servomouse/Tube_amplifier/Pics/Tube_amplifier_V0.1.jpg

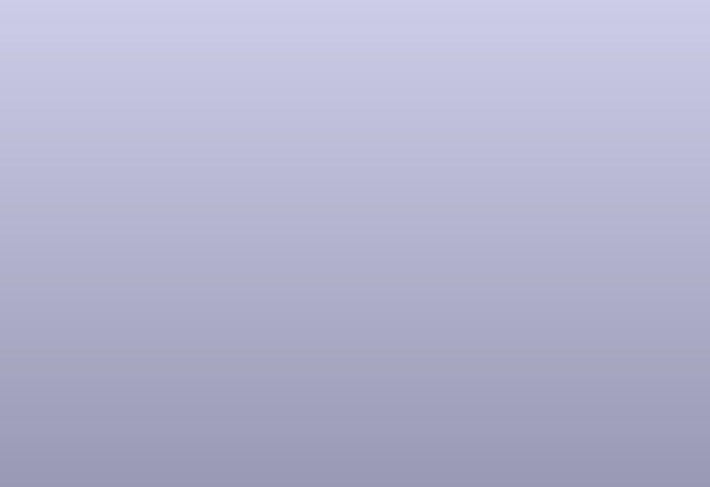
Pics/Tube_amplifier_V0.1.jpg
