servomouse/Tube_amplifier/Amplifier.png

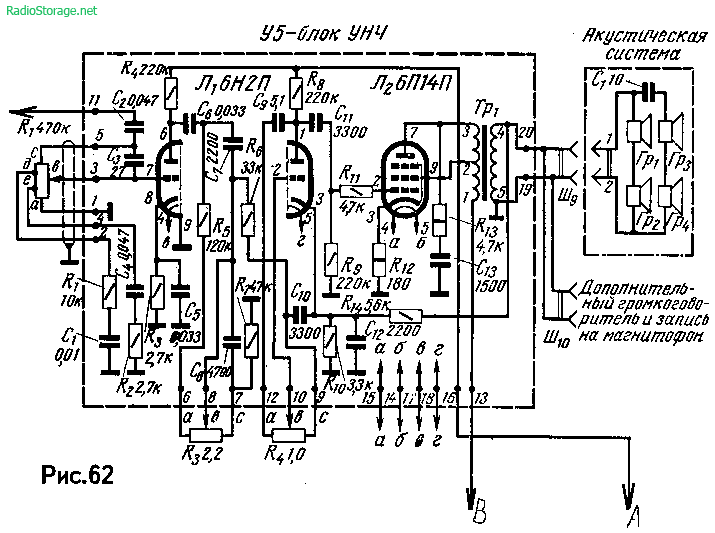
Amplifier.png
