servomouse/Tube_amplifier/Pics/lunch.jpg

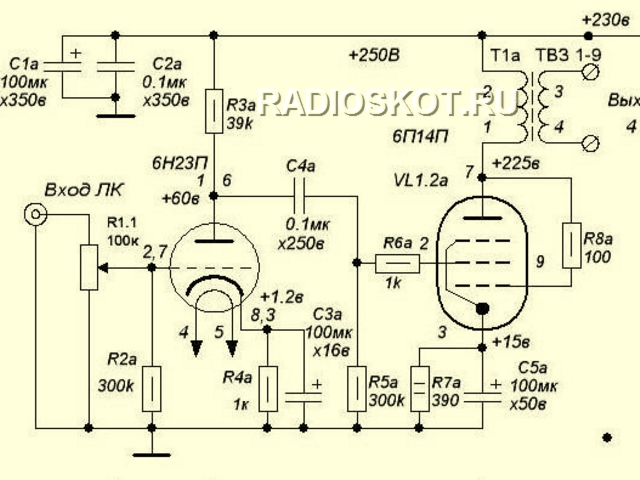
Pics/lunch.jpg
