servomouse/Tube_amplifier/Power supply.png

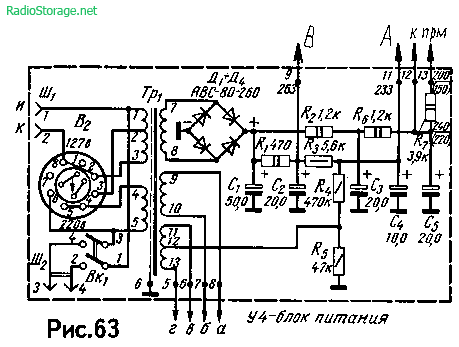
Power supply.png
