servomouse/Tube_amplifier/Transformer_params.png

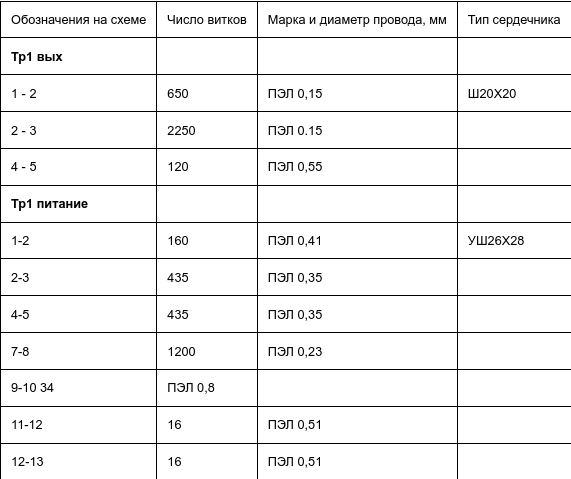
Transformer_params.png
