servomouse/Tube_amplifier/3d models/Chassis-Main_horizontal_plate.stl

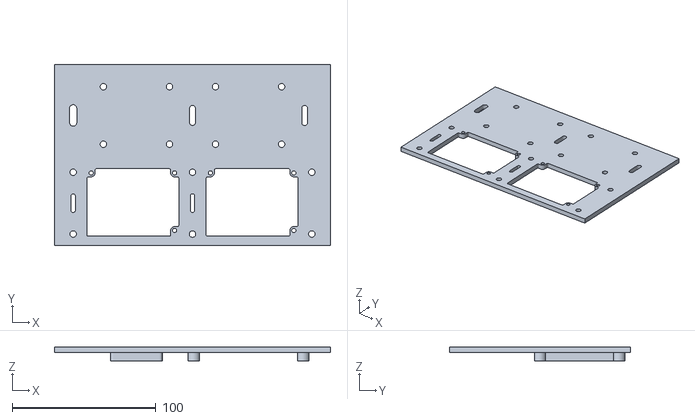
[picture p6: CAD file, 2023-05-01]
3d models/Chassis-Main_horizontal_plate.stl
192.0 x 126.0 x 10.0
