servomouse/Tube_amplifier/3d models/Transformers_holder_main.stl

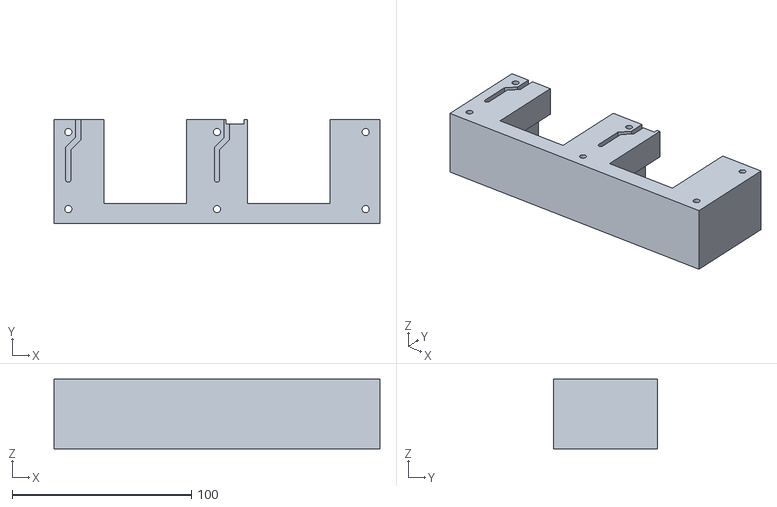
[picture p7: CAD file, 2023-05-01]
3d models/Transformers_holder_main.stl
182.0 x 58.0 x 39.0
