servomouse/Tube_amplifier/3d models/Asm.FCStd

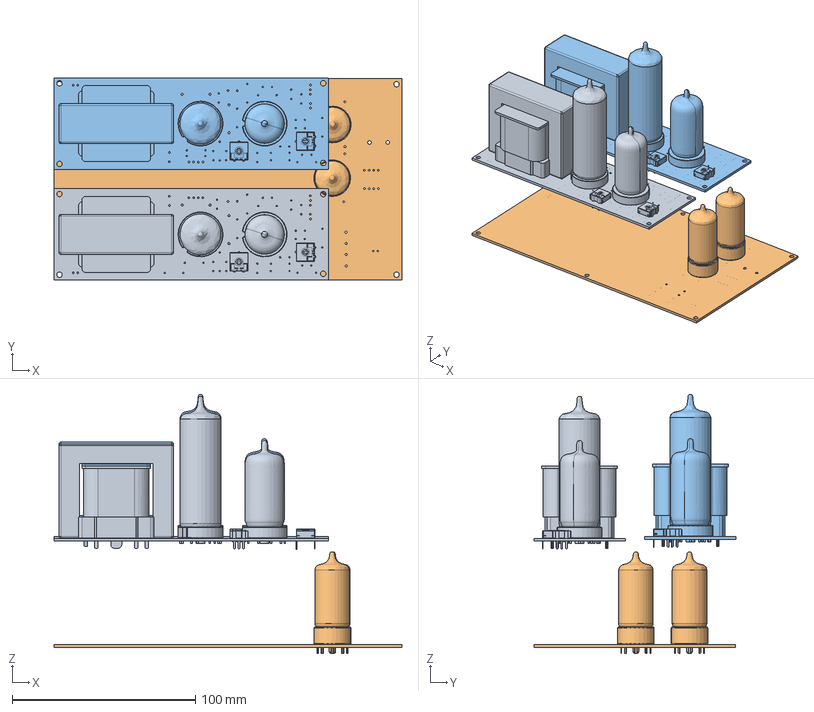
[picture p8: CAD file, 2022-12-16]
3d models/Asm.FCStd
190.0 x 110.5 x 141.5 mm
left_channel
Power_supply
right_channel
