servomouse/Tube_amplifier/3d models/Transformers_holder_inthemiddlestl.stl

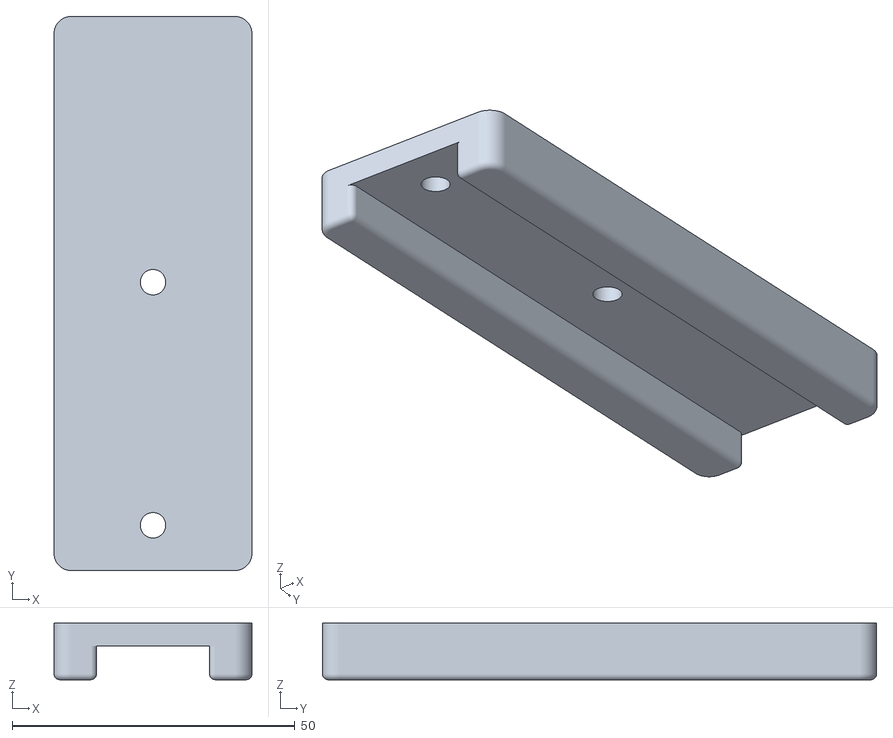
[picture p9: CAD file, 2023-05-01]
3d models/Transformers_holder_inthemiddlestl.stl
35.0 x 98.0 x 10.0
