servomouse/Tube_amplifier/3d models/Angle_mounted_SG2P.step

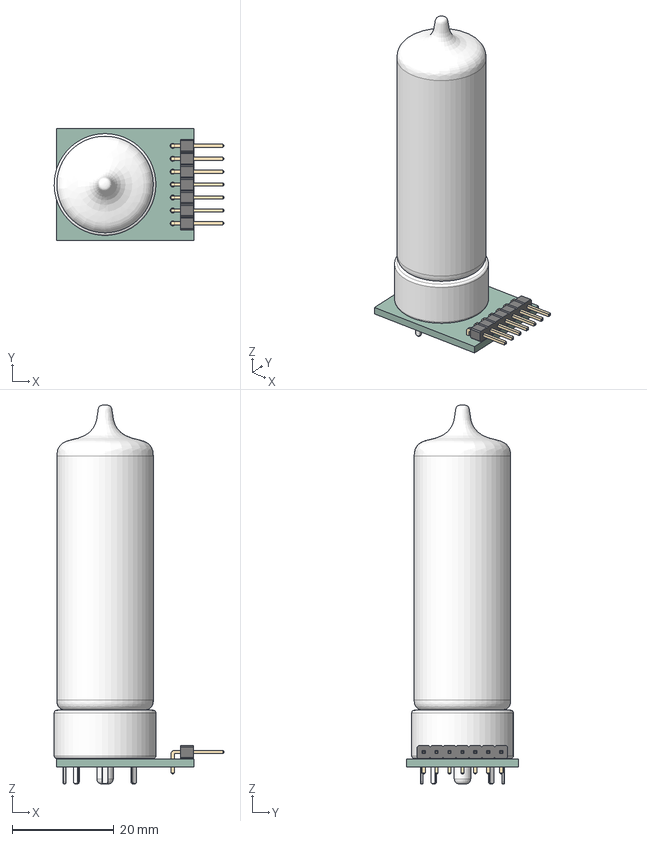
[picture p10: CAD file, 2023-05-01]
3d models/Angle_mounted_SG2P.step
33.3 x 22.0 x 74.5 mm
PCB
