servomouse/Tube_amplifier/3d models/Transformers_holder_rear.stl

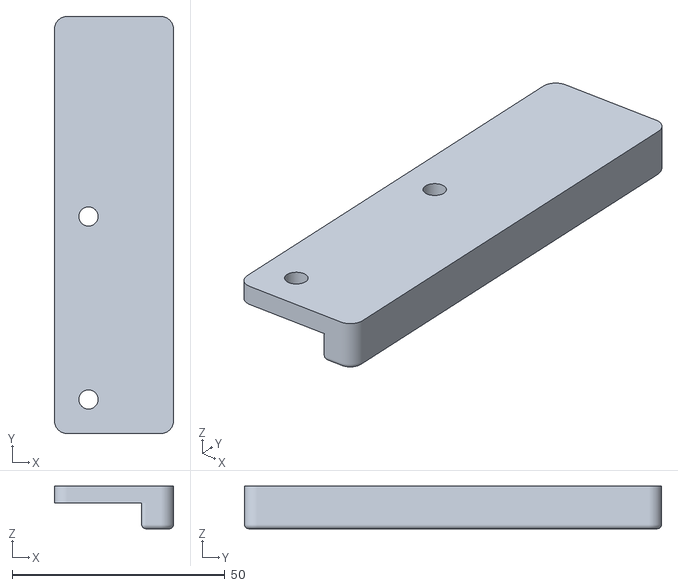
[picture p11: CAD file, 2023-05-01]
3d models/Transformers_holder_rear.stl
28.0 x 98.0 x 10.0
