servomouse/Tube_amplifier/3d models/PL9-3P.step

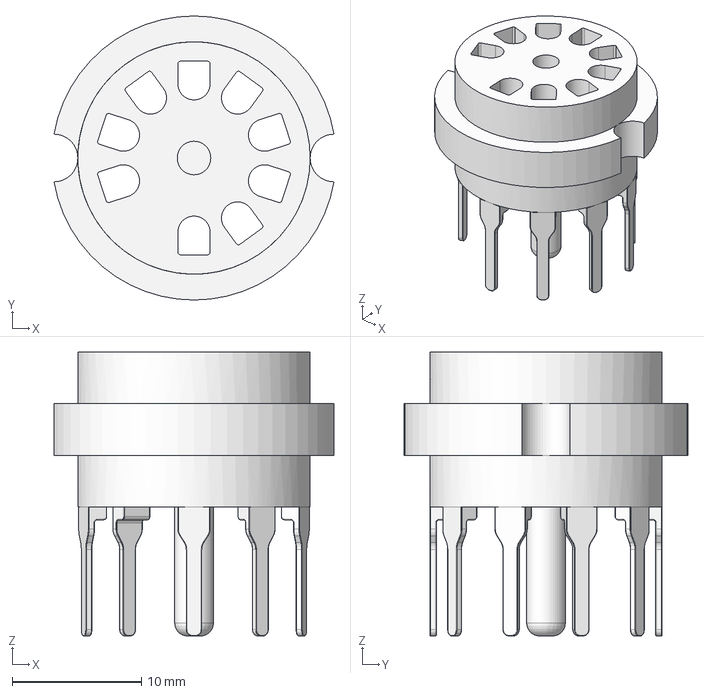
[picture p12: CAD file, 2023-02-15]
3d models/PL9-3P.step
21.7 x 22.0 x 22.0 mm
