servomouse/Tube_amplifier/3d models/Indication_board.step

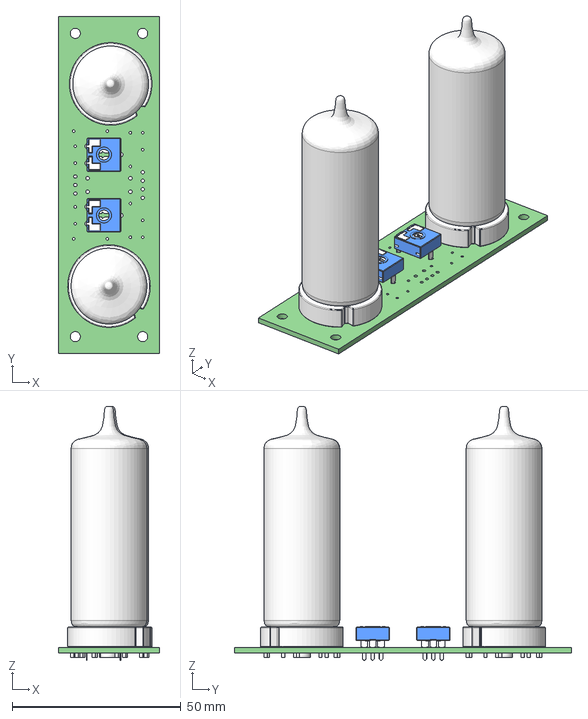
[picture p13: CAD file, 2023-02-14]
3d models/Indication_board.step
30.0 x 100.0 x 75.5 mm
Indication_board PCB
