servomouse/Tube_amplifier/3d models/Power_transformer.FCStd

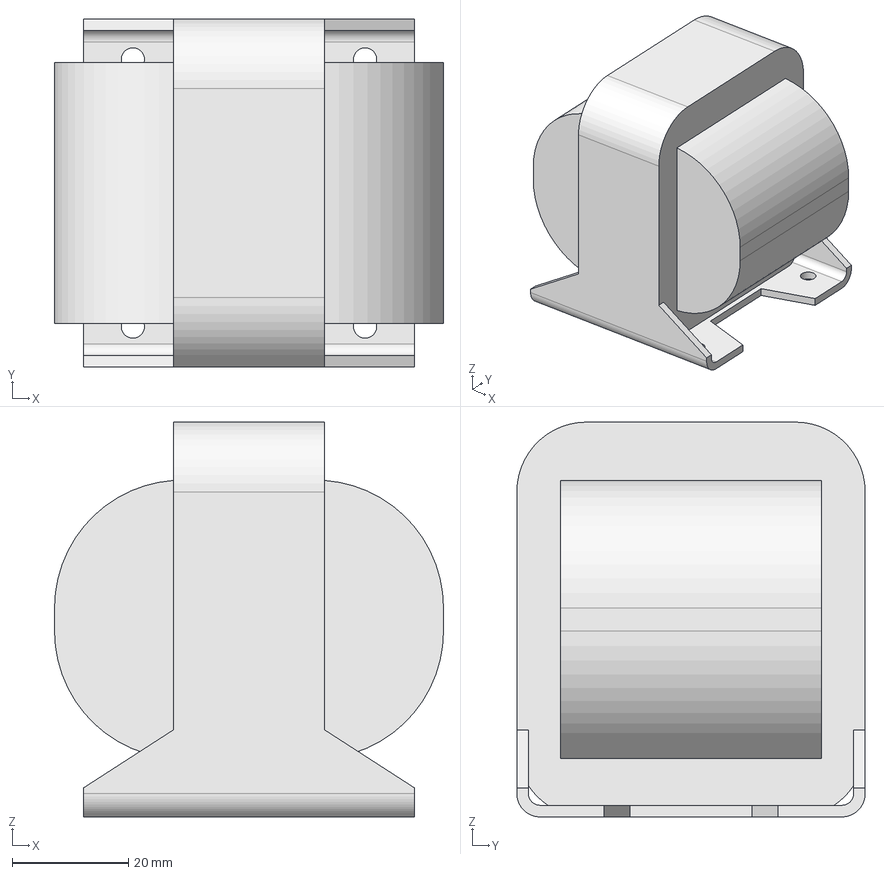
[picture p14: CAD file, 2023-02-06]
3d models/Power_transformer.FCStd
67.0 x 60.0 x 68.0 mm
