servomouse/Tube_amplifier/3d models/Chassis.FCStd

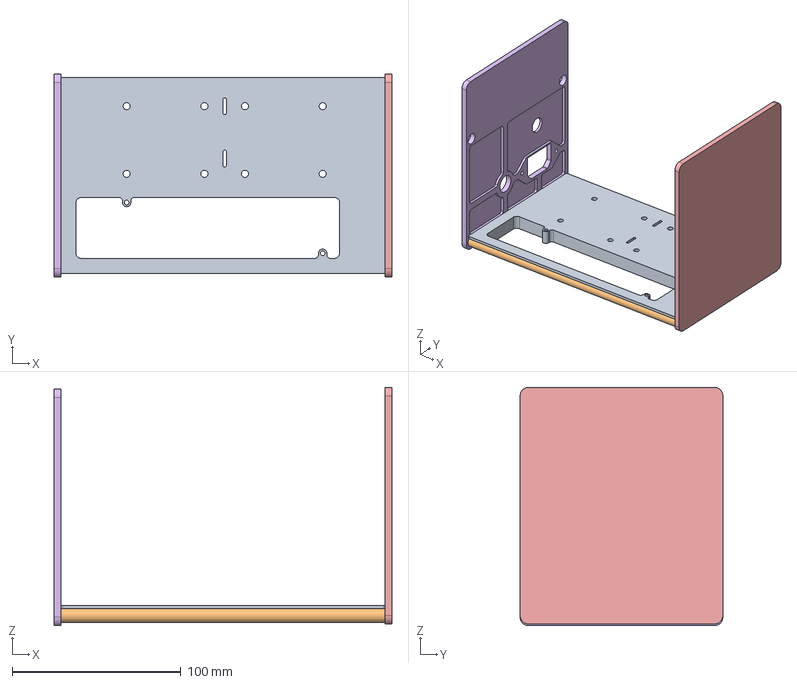
[picture p15: CAD file, 2023-02-05]
3d models/Chassis.FCStd
200.0 x 120.0 x 141.0 mm
back_plate
