servomouse/Tube_amplifier/3d models/back_plate.stl

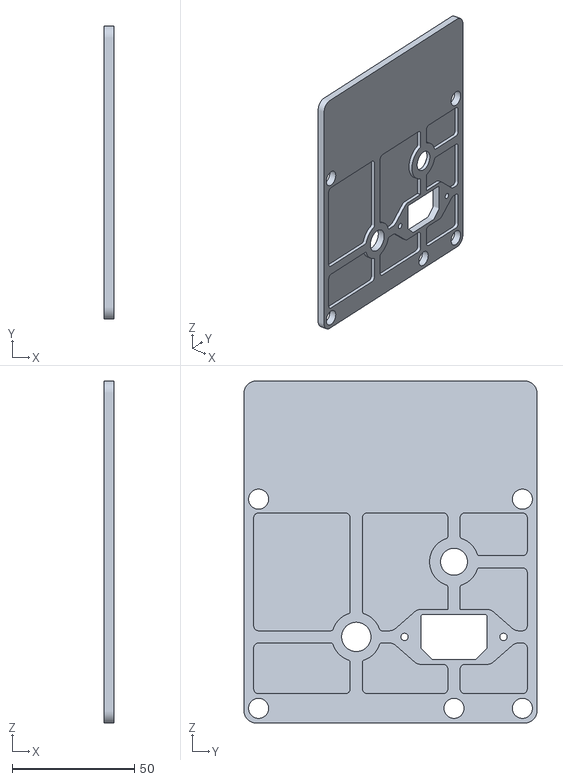
[picture p16: CAD file, 2023-02-05]
3d models/back_plate.stl
4.00 x 120.0 x 140.0
