servomouse/Tube_amplifier/3d models/Bottom_chassis.step

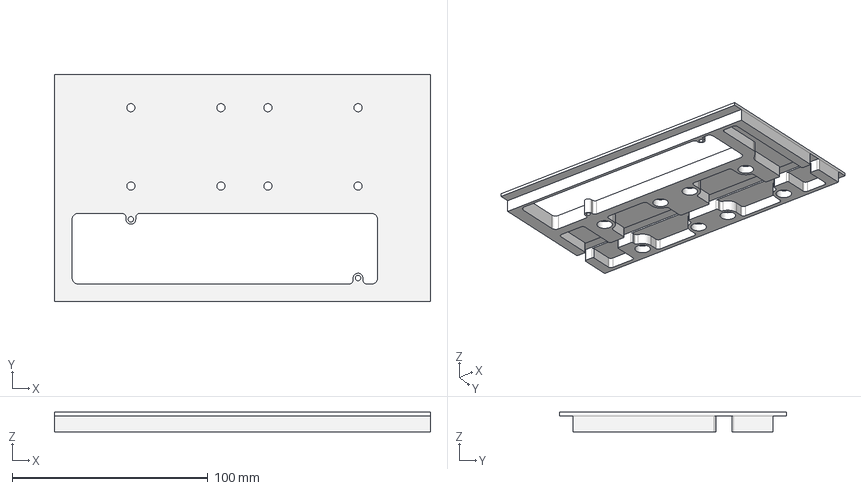
[picture p17: CAD file, 2023-01-23]
3d models/Bottom_chassis.step
192.0 x 116.0 x 10.0 mm
