servomouse/Tube_amplifier/3d models/power_supply_base.FCStd

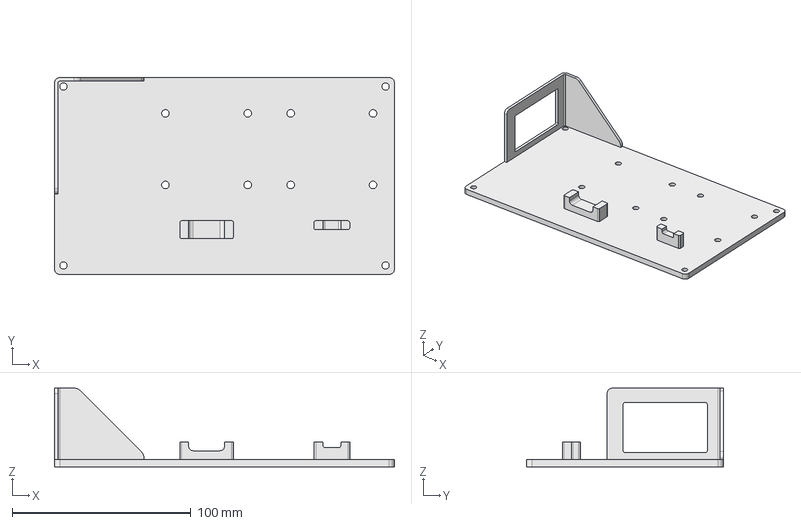
[picture p18: CAD file, 2023-01-04]
3d models/power_supply_base.FCStd
190.0 x 110.0 x 44.0 mm
