servomouse/Tube_amplifier/3d models/Transformer_pins_holder.FCStd

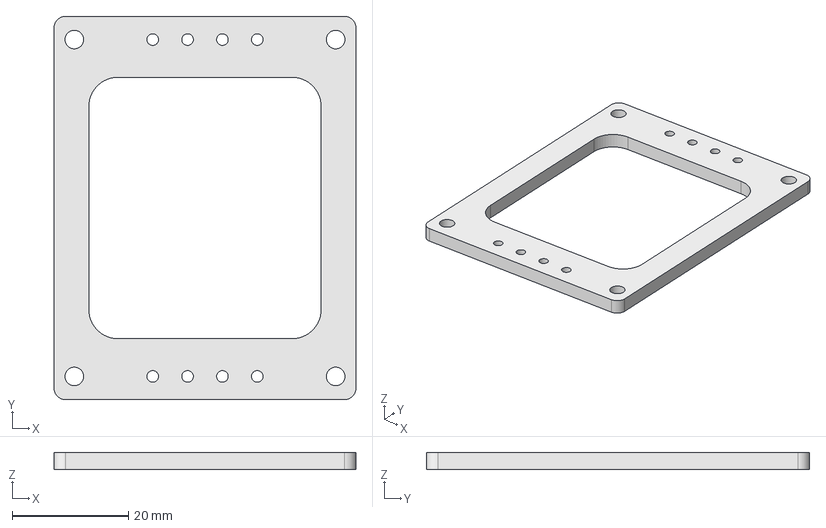
[picture p19: CAD file, 2023-01-04]
3d models/Transformer_pins_holder.FCStd
52.0 x 66.0 x 3.00 mm
