servomouse/Tube_amplifier/3d models/output_stage_base.FCStd

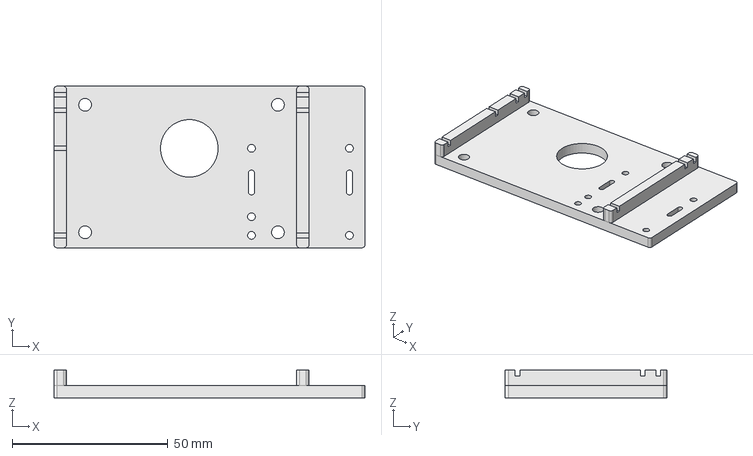
[picture p20: CAD file, 2023-01-04]
3d models/output_stage_base.FCStd
100.0 x 52.0 x 9.00 mm
