servomouse/Tube_amplifier/3d models/Power_supply.step

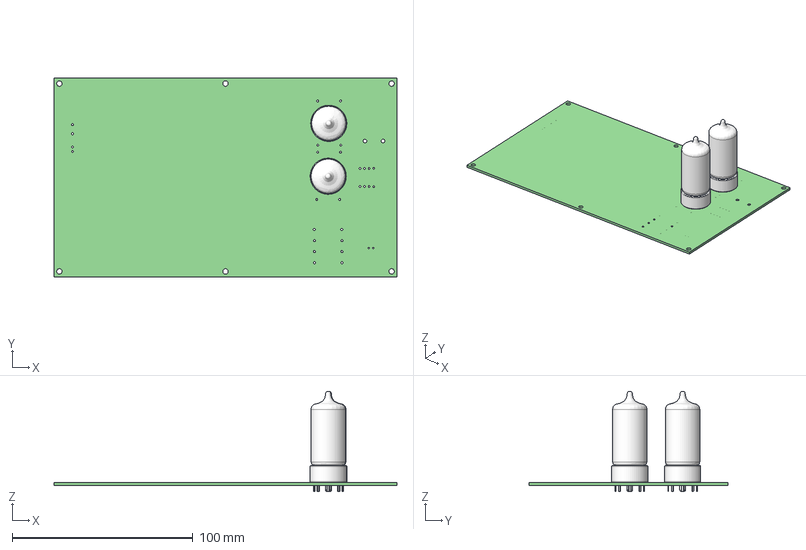
[picture p21: CAD file, 2022-12-16]
3d models/Power_supply.step
190.0 x 110.0 x 55.5 mm
Tube_amplifier PCB
