servomouse/Tube_amplifier/3d models/Output_transformer.step

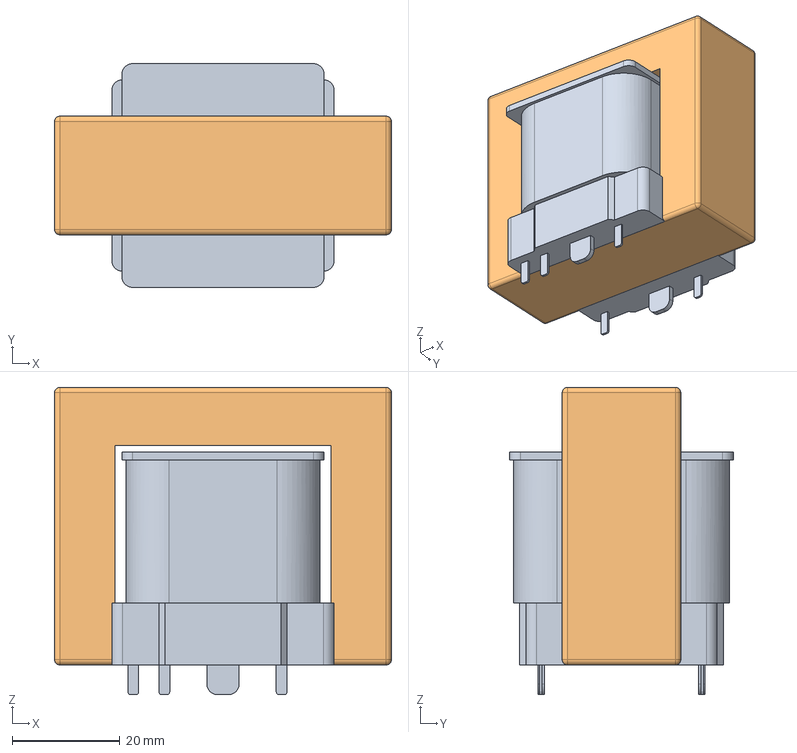
[picture p22: CAD file, 2022-12-14]
3d models/Output_transformer.step
62.5 x 41.5 x 57.0 mm
