servomouse/Tube_amplifier/3d models/7-pin socket.step

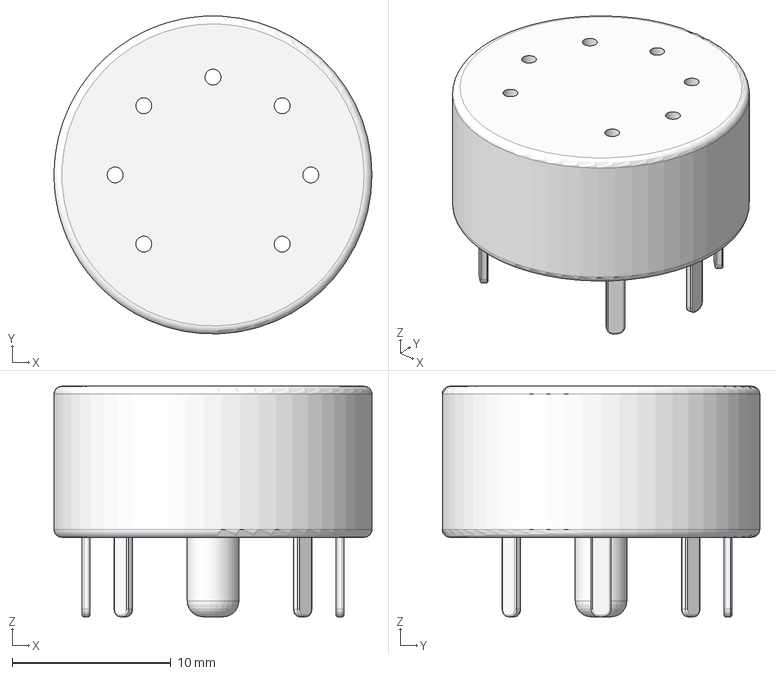
[picture p23: CAD file, 2022-12-13]
3d models/7-pin socket.step
20.0 x 20.0 x 14.5 mm
