servomouse/Tube_amplifier/3d models/9-pin socket.step

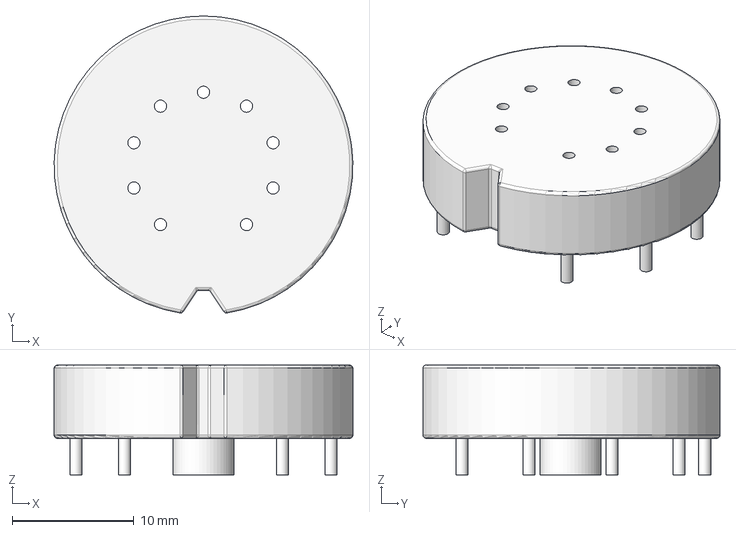
[picture p24: CAD file, 2022-12-11]
3d models/9-pin socket.step
24.5 x 24.4 x 9.00 mm
