servomouse/Tube_amplifier/(list of files, cad)

Other CAD files:
3d models/power_supply_base-Body.stl
3d models/7-pin socket.FCStd
3d models/9-pin socket.FCStd
3d models/9-pin socket.stl
3d models/Bottom_chassis.stl
3d models/Output_transformer.FCStd
3d models/PL9-3P.FCStd
3d models/Transformer_pins_holder.stl
3d models/bottom_chassis.FCStd
3d models/output_stage_base.stl
