servomouse/Tube_amplifier/Power_supply.kicad_pcb

## KiCad design Power_supply.kicad_pcb (2023-05-01)

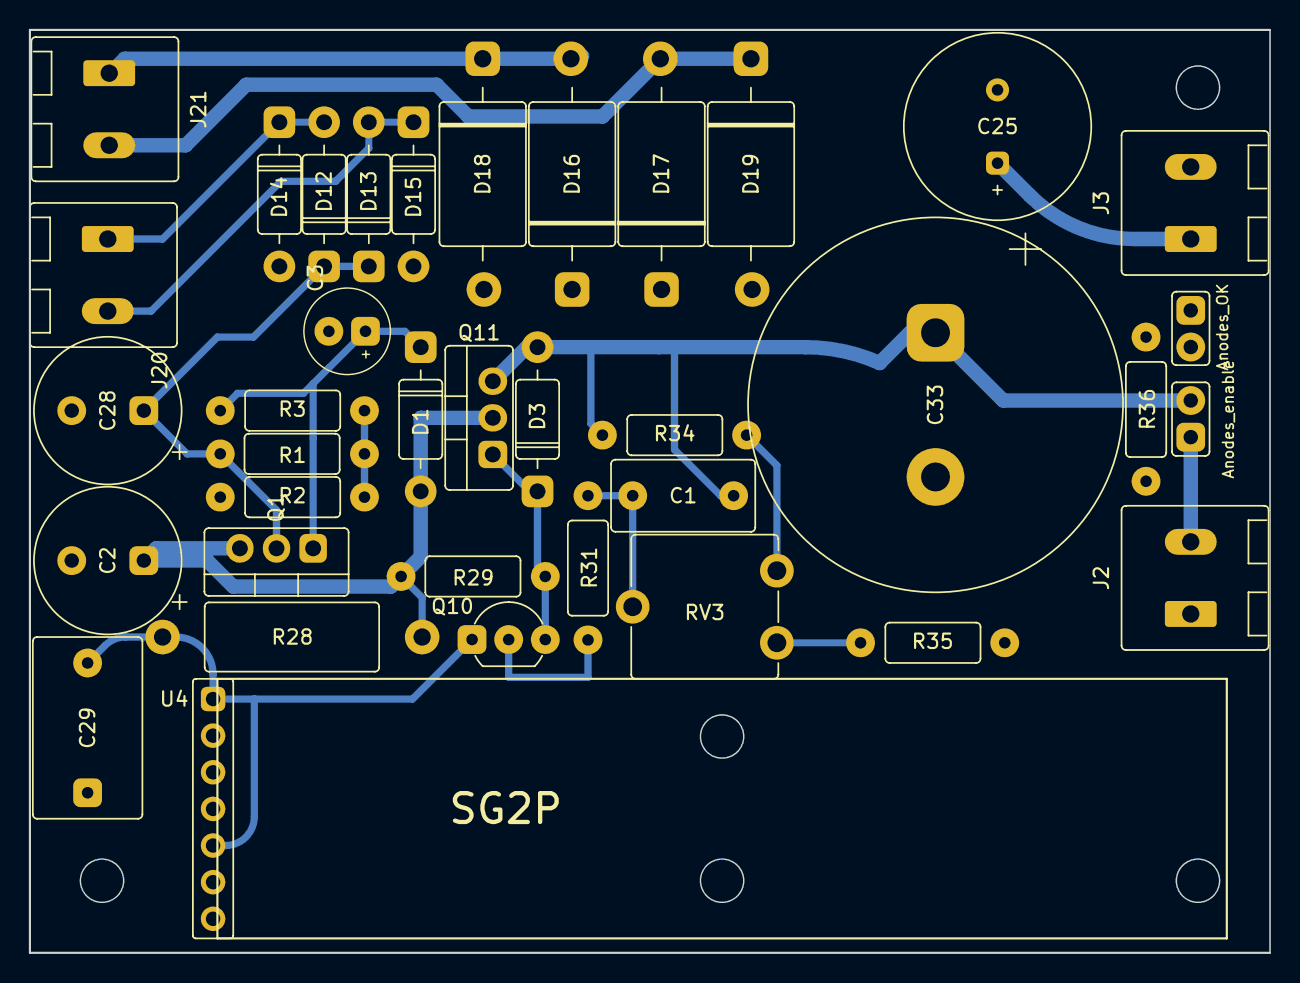
[picture p25: board Power_supply.kicad_pcb from above]

Board: 2 copper layers, 86.0 x 64.0 mm, 37 parts (0 on the bottom side), 19 nets.

Parts:
C1: 33n; C_THT_K73-17_P7.00mm
C2, C28: 10uF; C_THT_D10.0mm_P5.00mm
C3: 2,2uF; C_THT_D5.0mm_P2.54mm
C25: 3300uF_10V; C_THT_D13mm_P5.08mm
C29: 100n; C_THT_K73-17_P9.00mm
C33: 100uF; CP_Radial_D22.0mm_P10.00mm_SnapIn
D1, D3: 1N4740A; D_DO-41_short
D12, D13, D14, D15: 1n4007; D_DO-41_short
D16, D17, D18, D19: 1N5821; D_DO-27_P16mm_Horizontal
J2: 240V; MCV_1,5_4-G-5.0_1x02_P5.0mm_Vertical
J3: 6V3; MCV_1,5_4-G-5.0_1x02_P5.0mm_Vertical
J20: HV_Transformer; MCV_1,5_4-G-5.0_1x02_P5.0mm_Vertical
J21: LV_Transformer; MCV_1,5_4-G-5.0_1x02_P5.0mm_Vertical
J25: Anodes_enable; PinHeader_1x02_P2.54mm
NE4: Anodes_OK; PinHeader_1x02_P2.54mm
Q1, Q11: STP4NK60ZFP(MJE13003); TO-220-3_Vertical
Q10: MPSA42; TO-92_Wide
R1: 330k; R_THT_025W
R2: 10M; R_THT_025W
R3: 100; R_THT_025W
R28: 13k; R_THT_1W
R29: 10k; R_THT_025W
R31: 100k; R_THT_025W
R34: 50k; R_THT_025W
R35: 40k; R_THT_025W
R36: 1M; R_THT_025W
RV3: 10k; Potentiometer_THT_CA9V
U4: SG2P; PinHeader_1x07_P2.54mm

Connections:
240V: J2.2, J25.1
+6V: C25.1, D16.1 (K), D17.1 (K), J3.1
GND: C2.2, C3.2, C25.2, C28.2, C29.1, C33.2, D14.2 (A), D15.2 (A), D18.2 (A), D19.2 (A), J2.1, J3.2, NE4.1, R2.1, R35.2, U4.2, U4.4, U4.7
HV: C28.1, D12.1 (K), D13.1 (K), Q1.2 (D), R1.2
unnamed: C1.1, R31.1, RV3.2
unnamed: C2.1, D1.2 (A), Q1.3 (S), Q11.2 (D), R28.1, R29.2
unnamed: C3.1, D1.1 (K), Q1.1 (G), R3.1
unnamed: C1.2, C33.1, D3.2 (A), J25.2, Q11.3 (S), R34.1, R36.2
unnamed: D3.1 (K), Q10.3 (C), Q11.1 (G), R29.1
unnamed: D12.2 (A), D14.1 (K), J20.1
unnamed: D13.2 (A), D15.1 (K), J20.2
unnamed: D16.2 (A), D18.1 (K), J21.1
unnamed: D17.2 (A), D19.1 (K), J21.2
unnamed: NE4.2, R36.1
unnamed: Q10.2 (B), R31.2
unnamed: C29.2, Q10.1 (E), R28.2, U4.1, U4.5
unnamed: R1.1, R2.2, R3.2
unnamed: R34.2, RV3.1
unnamed: R35.1, RV3.3
