servomouse/Tube_amplifier/Amplifier_hybrid.kicad_pcb

## KiCad design Amplifier_hybrid.kicad_pcb (2023-05-01)

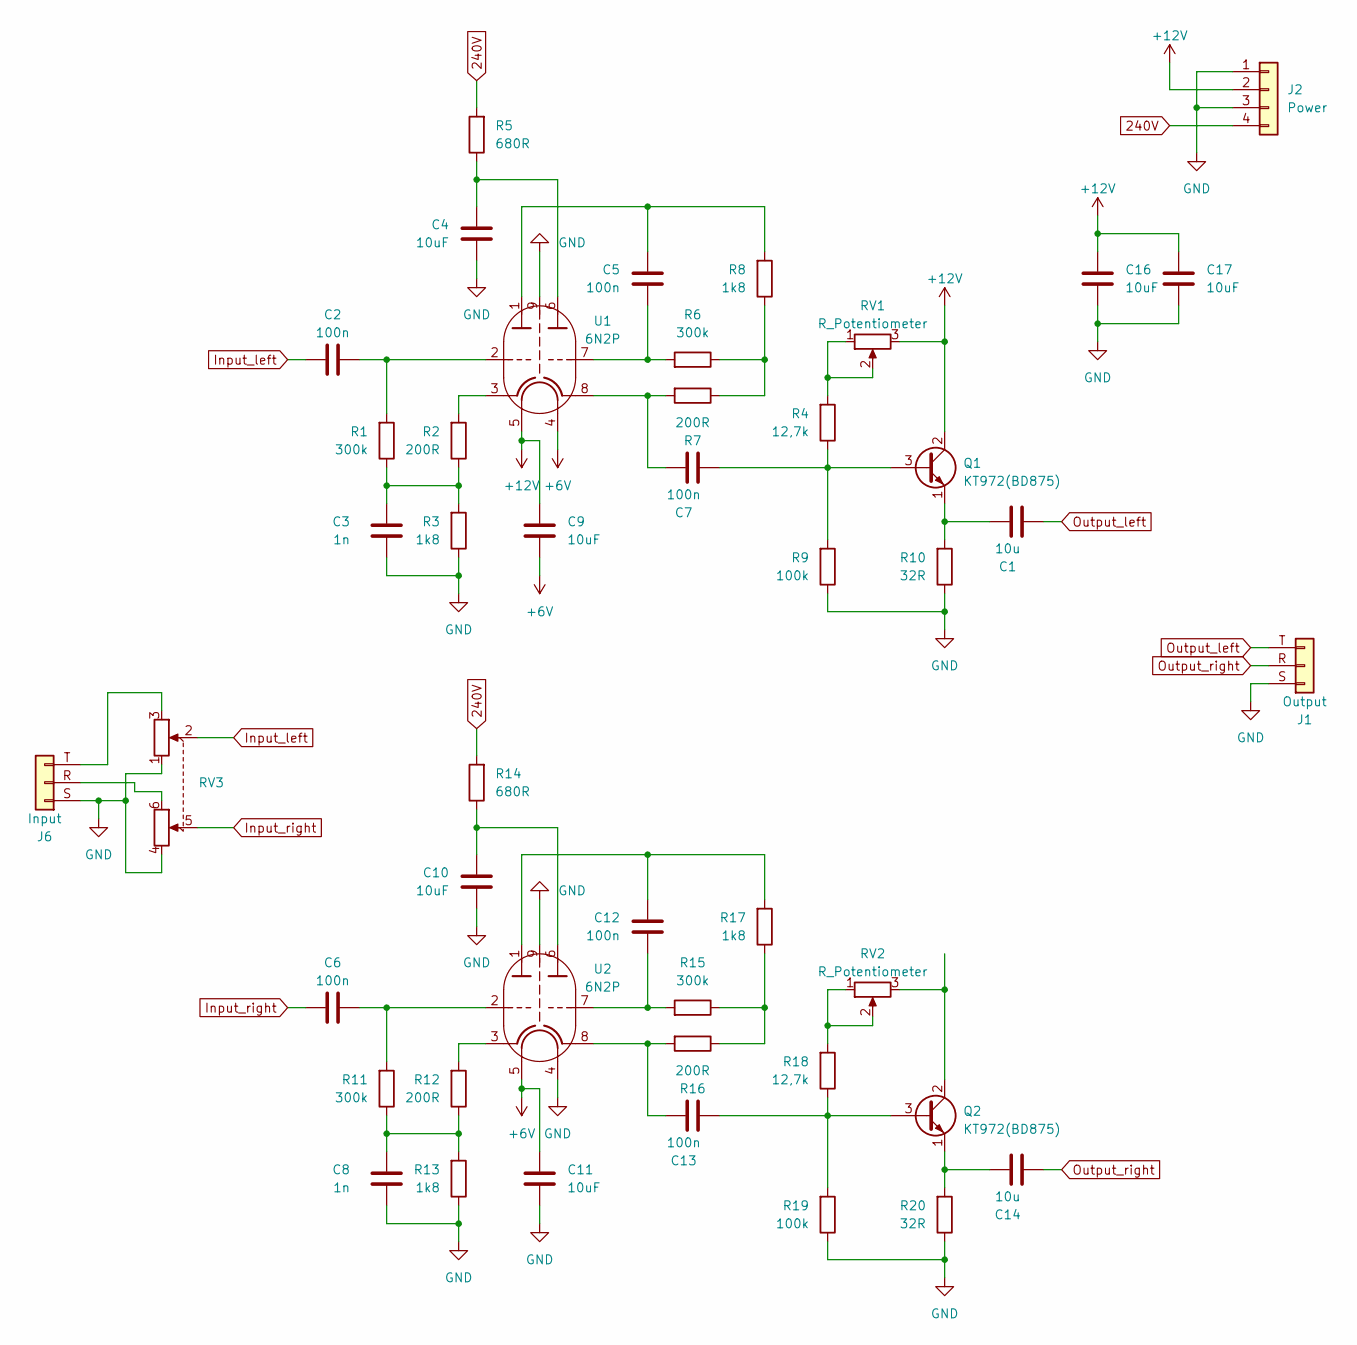
[picture p26: schematic Amplifier_hybrid.kicad_sch]

Parts:
C1, C14: 10u; C_THT_K73-17_P7.00mm
C2, C5, C6, C12: 100n; C_THT_K73-17_P9.00mm
C3, C8: 1n; C_THT_K73-17_P5.00mm
C4, C10, C16, C17: 10uF; C_THT_D10.0mm_P5.00mm
C7, C13: 100n; C_THT_K73-17_P7.00mm
C9, C11: 10uF; C_THT_D5.0mm_P2.54mm
J1: Output; Jack_6.35mm_Neutrik_NMJ6HFD2-AU_Horizontal
J2: Power; MCV_1,5_4-G-5.0_1x04_P5.0mm_Vertical
J6: Input; Jack_6.35mm_Neutrik_NMJ6HFD2-AU_Horizontal
Q1, Q2: КТ972(BD875); TO-126-3_Vertical
R1, R6, R11, R15: 300k; R_THT_025W
R2, R7, R12, R16: 200R; R_THT_025W
R3, R8, R13, R17: 1k8; R_THT_025W
R4, R18: 12,7k; R_THT_025W
R5, R14: 680R; R_THT_025W
R9, R19: 100k; R_THT_025W
R10, R20: 32R; R_THT_025W
RV1, RV2: R_Potentiometer; Potentiometer_THT_CA9V
RV3: R_Potentiometer_Dual; Potentiometer_Piher_T-16H_Double_Horizontal
U1, U2: 6N2P; PinHeader_1x09_P2.54mm

Connections:
240V: J2.4, R5.2, R14.2
+6V: C9.2, C11.1, U1.4, U2.5
+12V: C9.1, C16.1, C17.1, J2.2, Q1.2 (C), RV1.3, U1.5
GND: C3.2, C4.2, C8.2, C10.2, C11.2, C16.2, C17.2, J1.S (GND), J2.1, J2.3, J6.S (GND), R3.1, R9.1, R10.1, R13.1, R19.1, R20.1, RV3.1, RV3.4, U1.9, U2.4, U2.9
Input_left: C2.1, RV3.2
Input_right: C6.1, RV3.5
unnamed: C2.2, R1.2, U1.2
unnamed: C3.1, R1.1, R2.1, R3.2
unnamed: C4.1, R5.1, U1.6
unnamed: C5.1, R6.2, U1.7
unnamed: C5.2, R8.2, U1.1
unnamed: C6.2, R11.2, U2.2
unnamed: C7.1, R7.2, U1.8
unnamed: C8.1, R11.1, R12.1, R13.2
unnamed: C10.1, R14.1, U2.6
unnamed: C12.1, R15.2, U2.7
unnamed: C12.2, R17.2, U2.1
unnamed: C13.1, R16.2, U2.8
unnamed: J6.T (L), RV3.3
unnamed: J6.R, RV3.6
unnamed: C7.2, Q1.3 (B), R4.1, R9.2
unnamed: C1.1, Q1.1 (E), R10.2
unnamed: C13.2, Q2.3 (B), R18.1, R19.2
unnamed: Q2.2 (C), RV2.3
unnamed: C14.1, Q2.1 (E), R20.2
unnamed: R2.2, U1.3
unnamed: R4.2, RV1.1, RV1.2
unnamed: R6.1, R7.1, R8.1
unnamed: R12.2, U2.3
unnamed: R15.1, R16.1, R17.1
unnamed: R18.2, RV2.1, RV2.2
Output_left: C1.2, J1.T (L)
Output_right: C14.2, J1.R

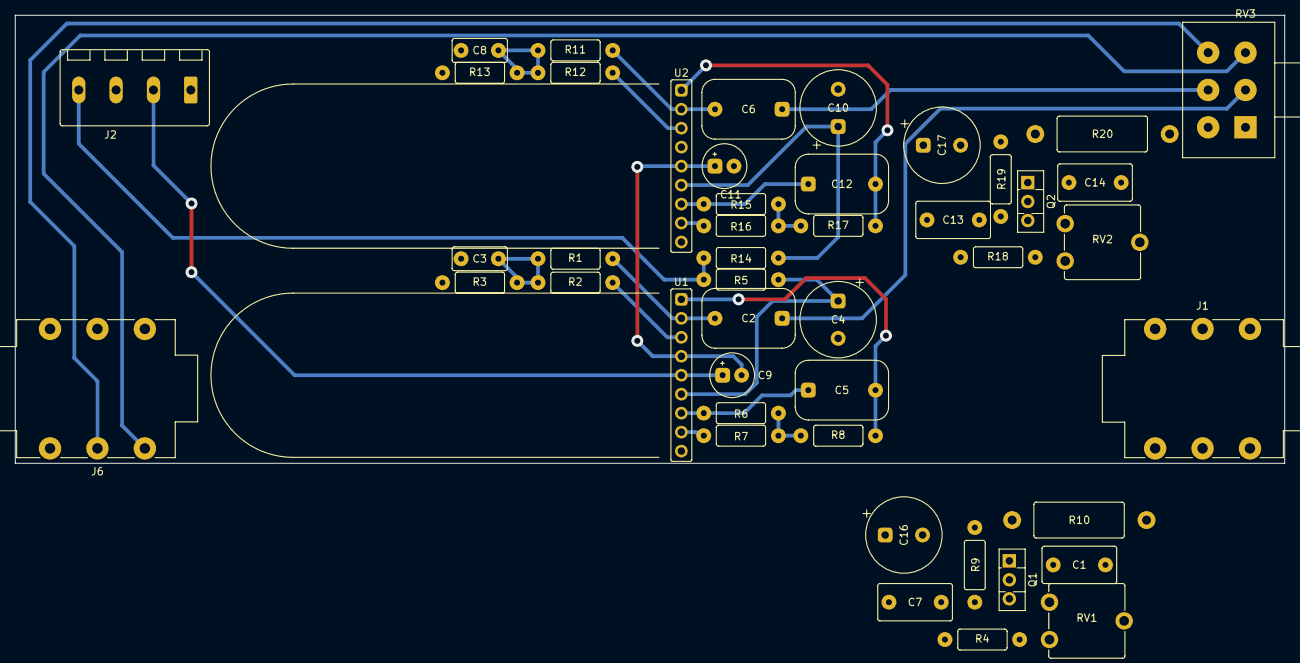
[picture p27: board Amplifier_hybrid.kicad_pcb from above]

Board: 2 copper layers, 170.0 x 60.0 mm, 46 parts (0 on the bottom side), 33 nets.
