servomouse/Tube_amplifier/Amplifier.kicad_pcb

## KiCad design Amplifier.kicad_pcb (2023-05-01)

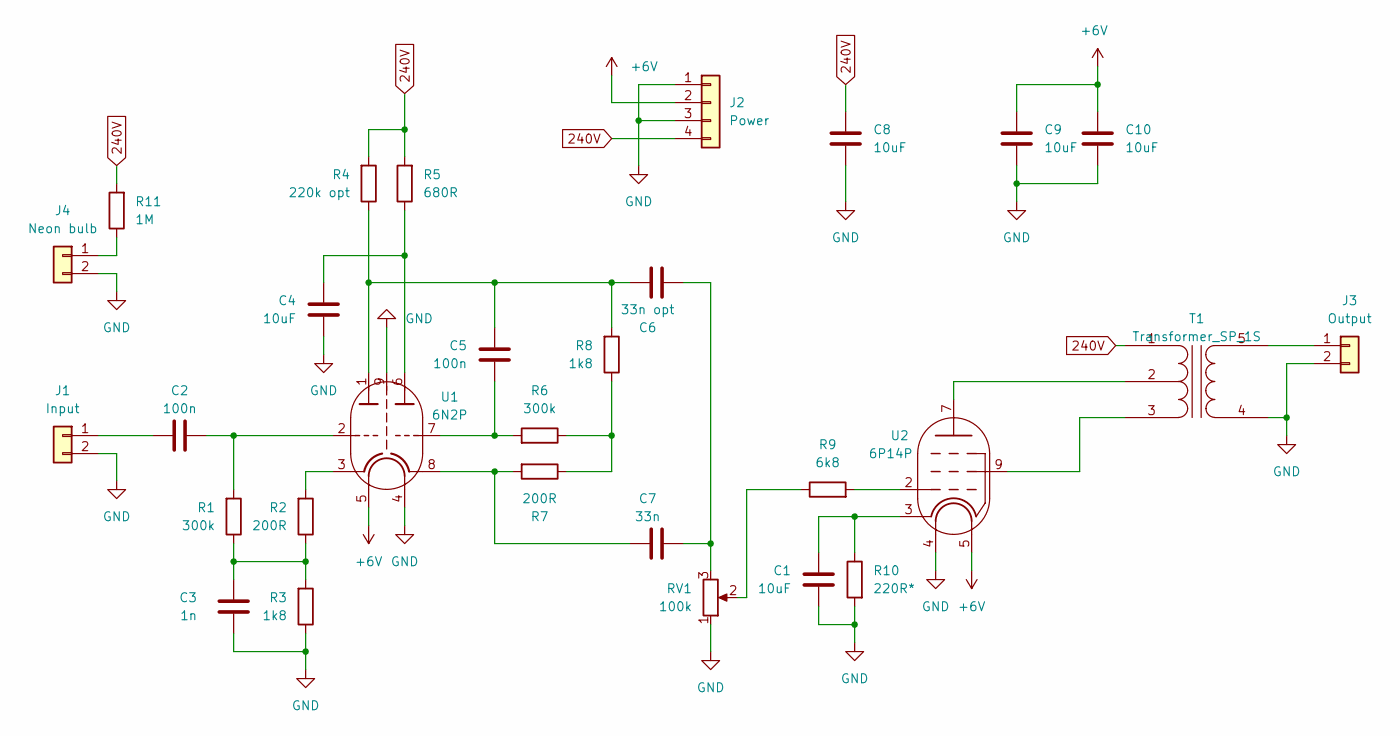
[picture p28: schematic Amplifier.kicad_sch]

Parts:
C1, C4, C8: 10uF; C_THT_D10.0mm_P5.00mm
C2, C5: 100n; C_THT_K73-17_P9.00mm
C3: 1n; C_THT_K73-17_P5.00mm
C6: 33n opt; C_THT_K73-17_P7.00mm
C7: 33n; C_THT_K73-17_P7.00mm
C9, C10: 10uF; C_THT_D5.0mm_P2.54mm
J1: Input; PinHeader_1x02_P2.54mm
J2: Power; MCV_1,5_4-G-3.5_1x04_P3.50mm_Vertical
J3: Output; PinHeader_1x02_P2.54mm
J4: Neon bulb; PinHeader_1x02_P2.54mm
R1, R6: 300k; R_THT_025W
R2, R7: 200R; R_THT_025W
R3, R8: 1k8; R_THT_025W
R4: 220k opt; R_THT_025W
R5: 680R; R_THT_025W
R9: 6k8; R_THT_025W
R10: 220R*; R_THT_1W
R11: 1M; R_THT_025W
RV1: 100k; Potentiometer_THT_CA9V
T1: Transformer_SP_1S; Output_transformer
U1: 6N2P; 9-pin_tube_socket
U2: 6P14P; 9-pin_tube_socket

Connections:
240V: C8.1, J2.4, R4.2, R5.2, R11.2, T1.1 (PR1)
+6V: C9.1, C10.1, J2.2, U1.5, U2.5
GND: C1.2, C3.2, C4.2, C8.2, C9.2, C10.2, J1.2, J2.1, J2.3, J3.2, J4.2, R3.1, R10.2, RV1.1, T1.4 (S1), U1.4, U1.9, U2.4
unnamed: C1.1, R10.1, U2.3
unnamed: C2.2, R1.2, U1.2
unnamed: C3.1, R1.1, R2.1, R3.2
unnamed: C4.1, R5.1, U1.6
unnamed: C5.1, R6.2, U1.7
unnamed: C5.2, C6.1, R4.1, R8.2, U1.1
unnamed: C6.2, C7.2, RV1.3
unnamed: C7.1, R7.2, U1.8
unnamed: C2.1, J1.1
unnamed: J3.1, T1.5 (S2)
unnamed: J4.1, R11.1
unnamed: R2.2, U1.3
unnamed: R6.1, R7.1, R8.1
unnamed: R9.1, RV1.2
unnamed: R9.2, U2.2
unnamed: T1.2 (PM), U2.7
unnamed: T1.3 (PR2), U2.9

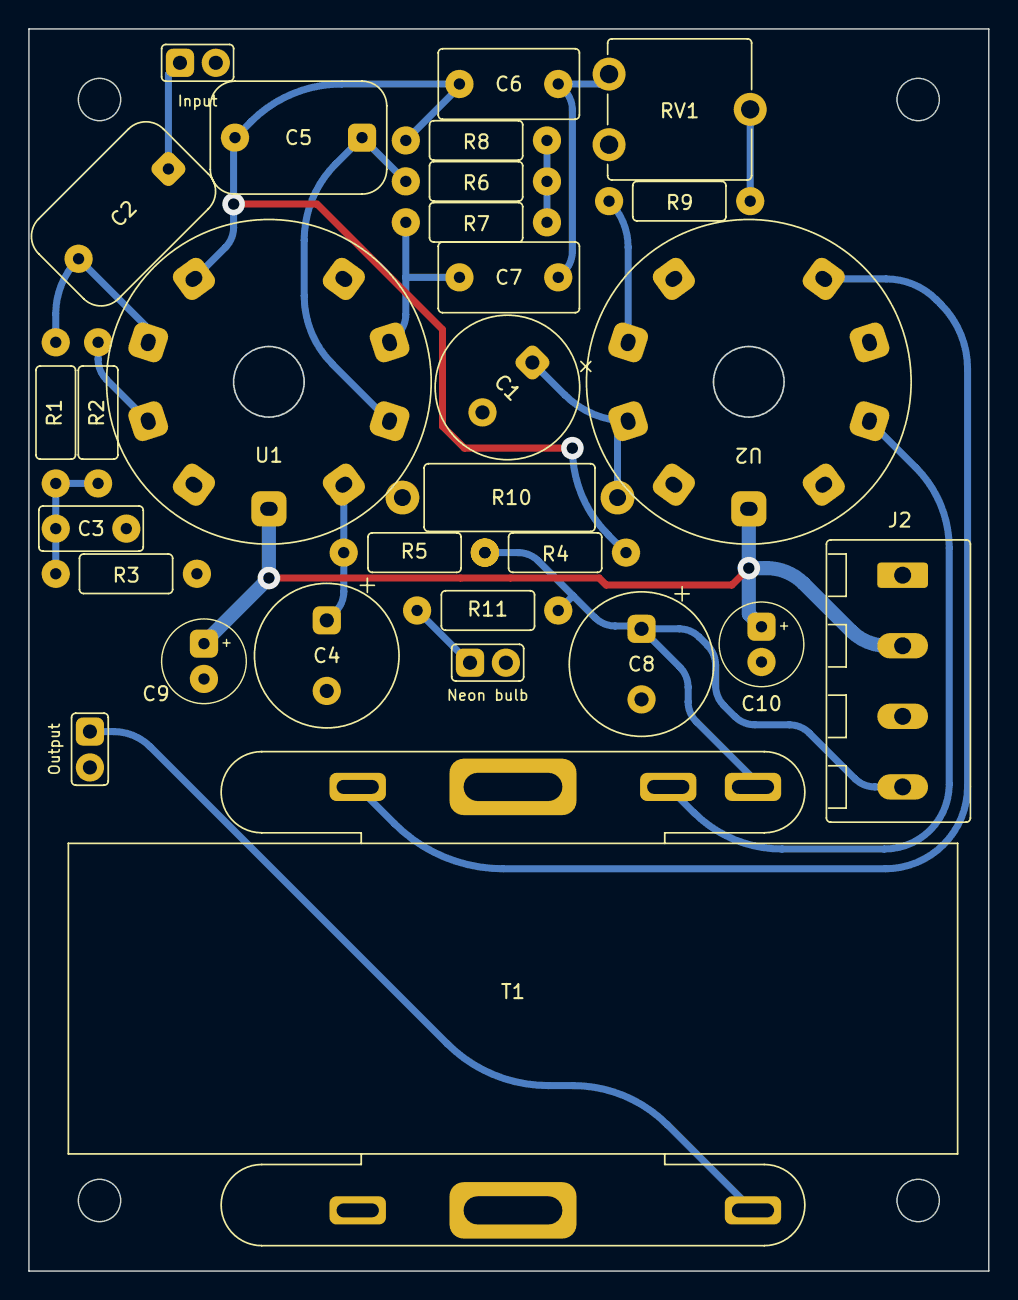
[picture p29: board Amplifier.kicad_pcb from above]

Board: 2 copper layers, 68.0 x 88.0 mm, 29 parts (0 on the bottom side), 20 nets.
