servomouse/Tube_amplifier/Indication_board.kicad_pcb

## KiCad design Indication_board.kicad_pcb (2023-02-15)

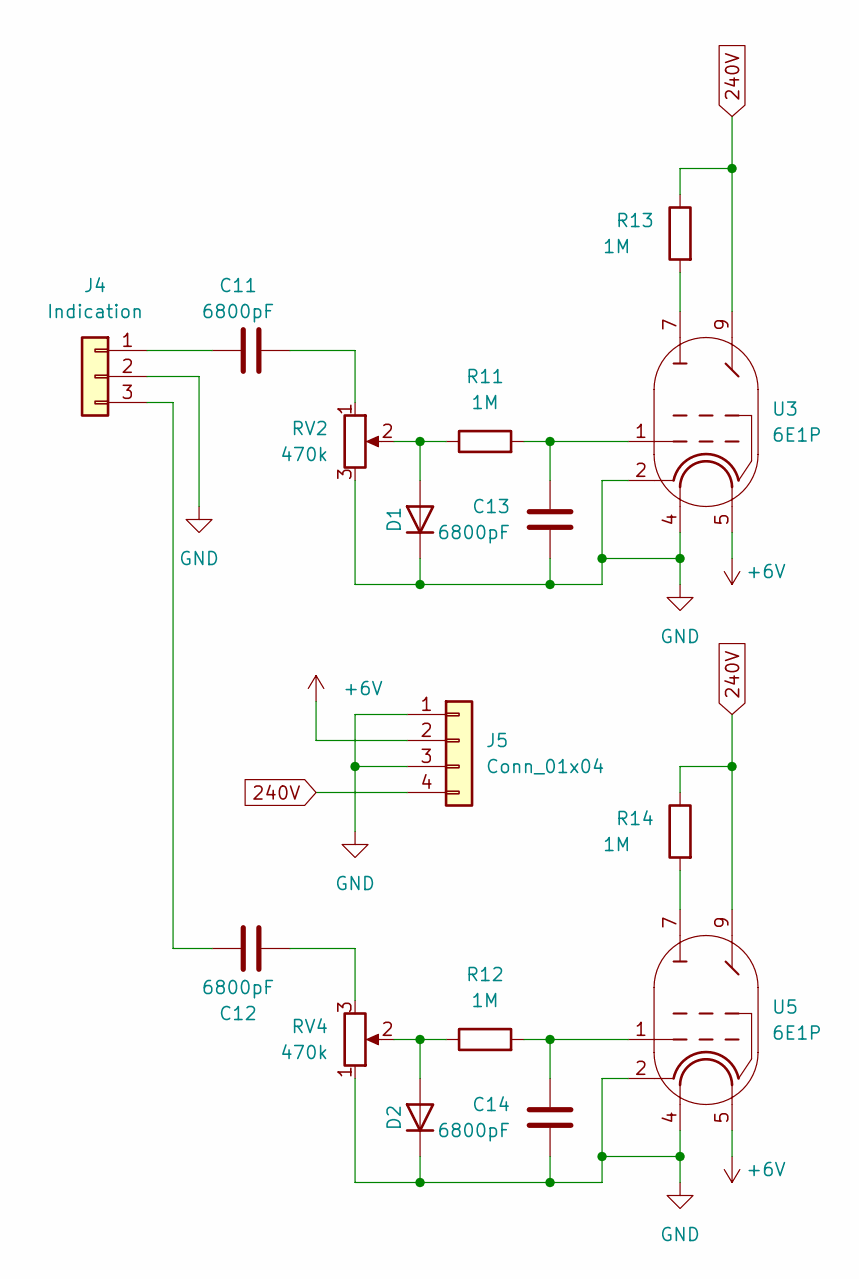
[picture p30: schematic Indication_board.kicad_sch]

Parts:
C11, C12, C13, C14: 6800pF; C_THT_K73-17_P5.00mm
D1, D2: 1n4007; D_DO-41_SOD81_P12.70mm_Horizontal
J4: Indication; PinHeader_1x03_P2.54mm
J5: Conn_01x04; PinHeader_1x04_P2.54mm
R11, R12, R13, R14: 1M; R_THT_025W
RV2, RV4: 470k; Potentiometer_THT_CA9V
U3, U5: 6E1P; 9-pin_tube_socket

Connections:
240V: J5.4, R13.1, R14.1, U3.9, U5.9
+6V: J5.2, U3.5, U5.5
GND: C13.2, C14.2, D1.1 (K), D2.1 (K), J4.2, J5.1, J5.3, RV2.3, RV4.1, U3.2, U3.4, U5.2, U5.4
unnamed: C11.1, J4.1
unnamed: C11.2, RV2.1
unnamed: C12.1, J4.3
unnamed: C12.2, RV4.3
unnamed: C13.1, R11.2, U3.1
unnamed: C14.1, R12.2, U5.1
unnamed: D1.2 (A), R11.1, RV2.2
unnamed: D2.2 (A), R12.1, RV4.2
unnamed: R13.2, U3.7
unnamed: R14.2, U5.7

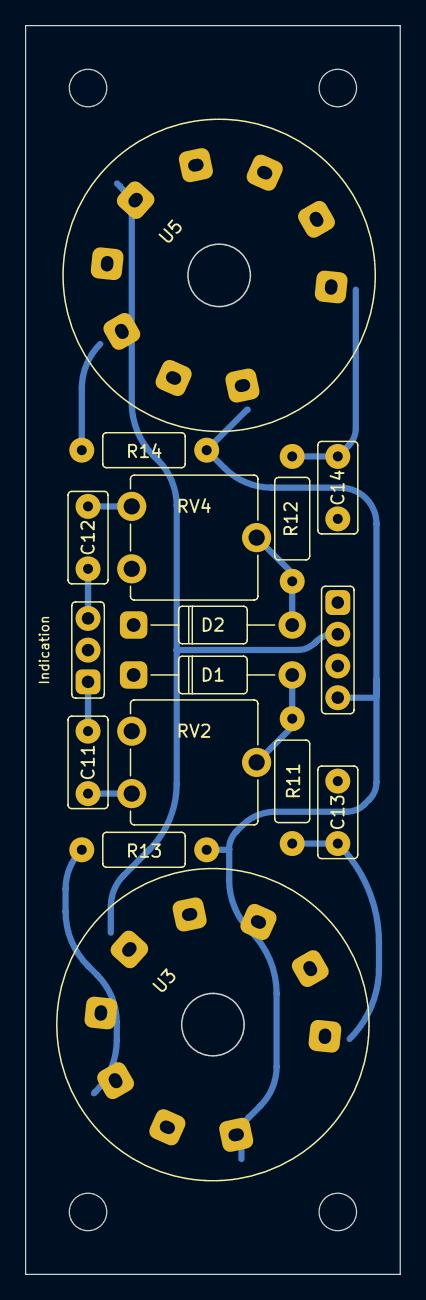
[picture p31: board Indication_board.kicad_pcb from above]

Board: 2 copper layers, 30.0 x 100.0 mm, 16 parts (0 on the bottom side), 13 nets.
