servomouse/Tube_amplifier/vt_fb_rectifier.kicad_pcb

## KiCad design vt_fb_rectifier.kicad_pcb (2023-02-04)

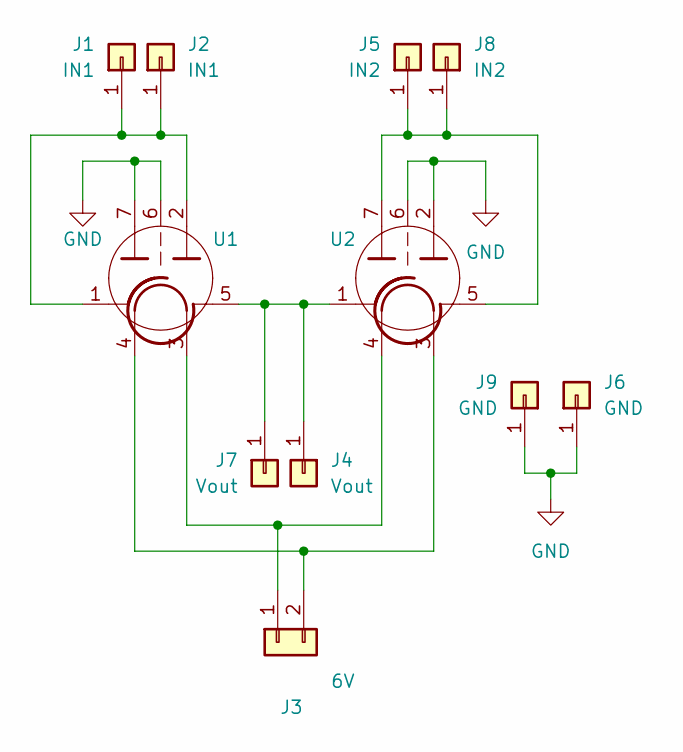
[picture p32: schematic vt_fb_rectifier.kicad_sch]

Parts:
J1, J2: IN1; PinHeader_1x01_P2.54mm_Vertical
J3: 6V; PinHeader_1x02_P2.54mm
J4, J7: Vout; PinHeader_1x01_P2.54mm_Vertical
J5, J8: IN2; PinHeader_1x01_P2.54mm_Vertical
J6, J9: GND; PinHeader_1x01_P2.54mm_Vertical
U1, U2: 6H2P; 7-pin_tube_socket

Connections:
GND: J6.1, J9.1, U1.6, U1.7, U2.2, U2.6
unnamed: J1.1, J2.1, U1.1, U1.2
unnamed: J3.1, U1.3, U2.4
unnamed: J3.2, U1.4, U2.3
unnamed: J4.1, J7.1, U1.5, U2.1
unnamed: J5.1, J8.1, U2.5, U2.7

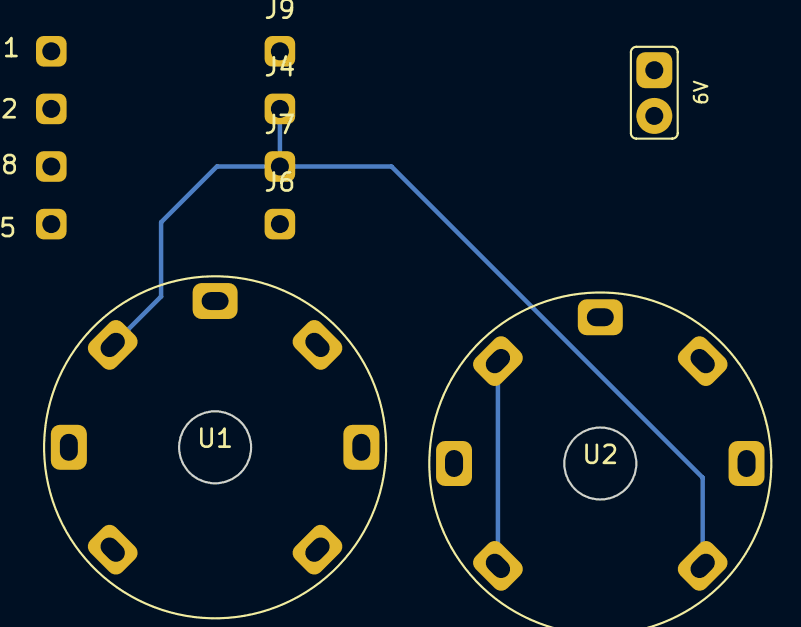
[picture p33: board vt_fb_rectifier.kicad_pcb from above]

Board: 2 copper layers, 11 parts (0 on the bottom side), 6 nets.
