servomouse/Tube_amplifier/Tube_amplifier.kicad_pcb

## KiCad design Tube_amplifier.kicad_pcb (2023-01-08)

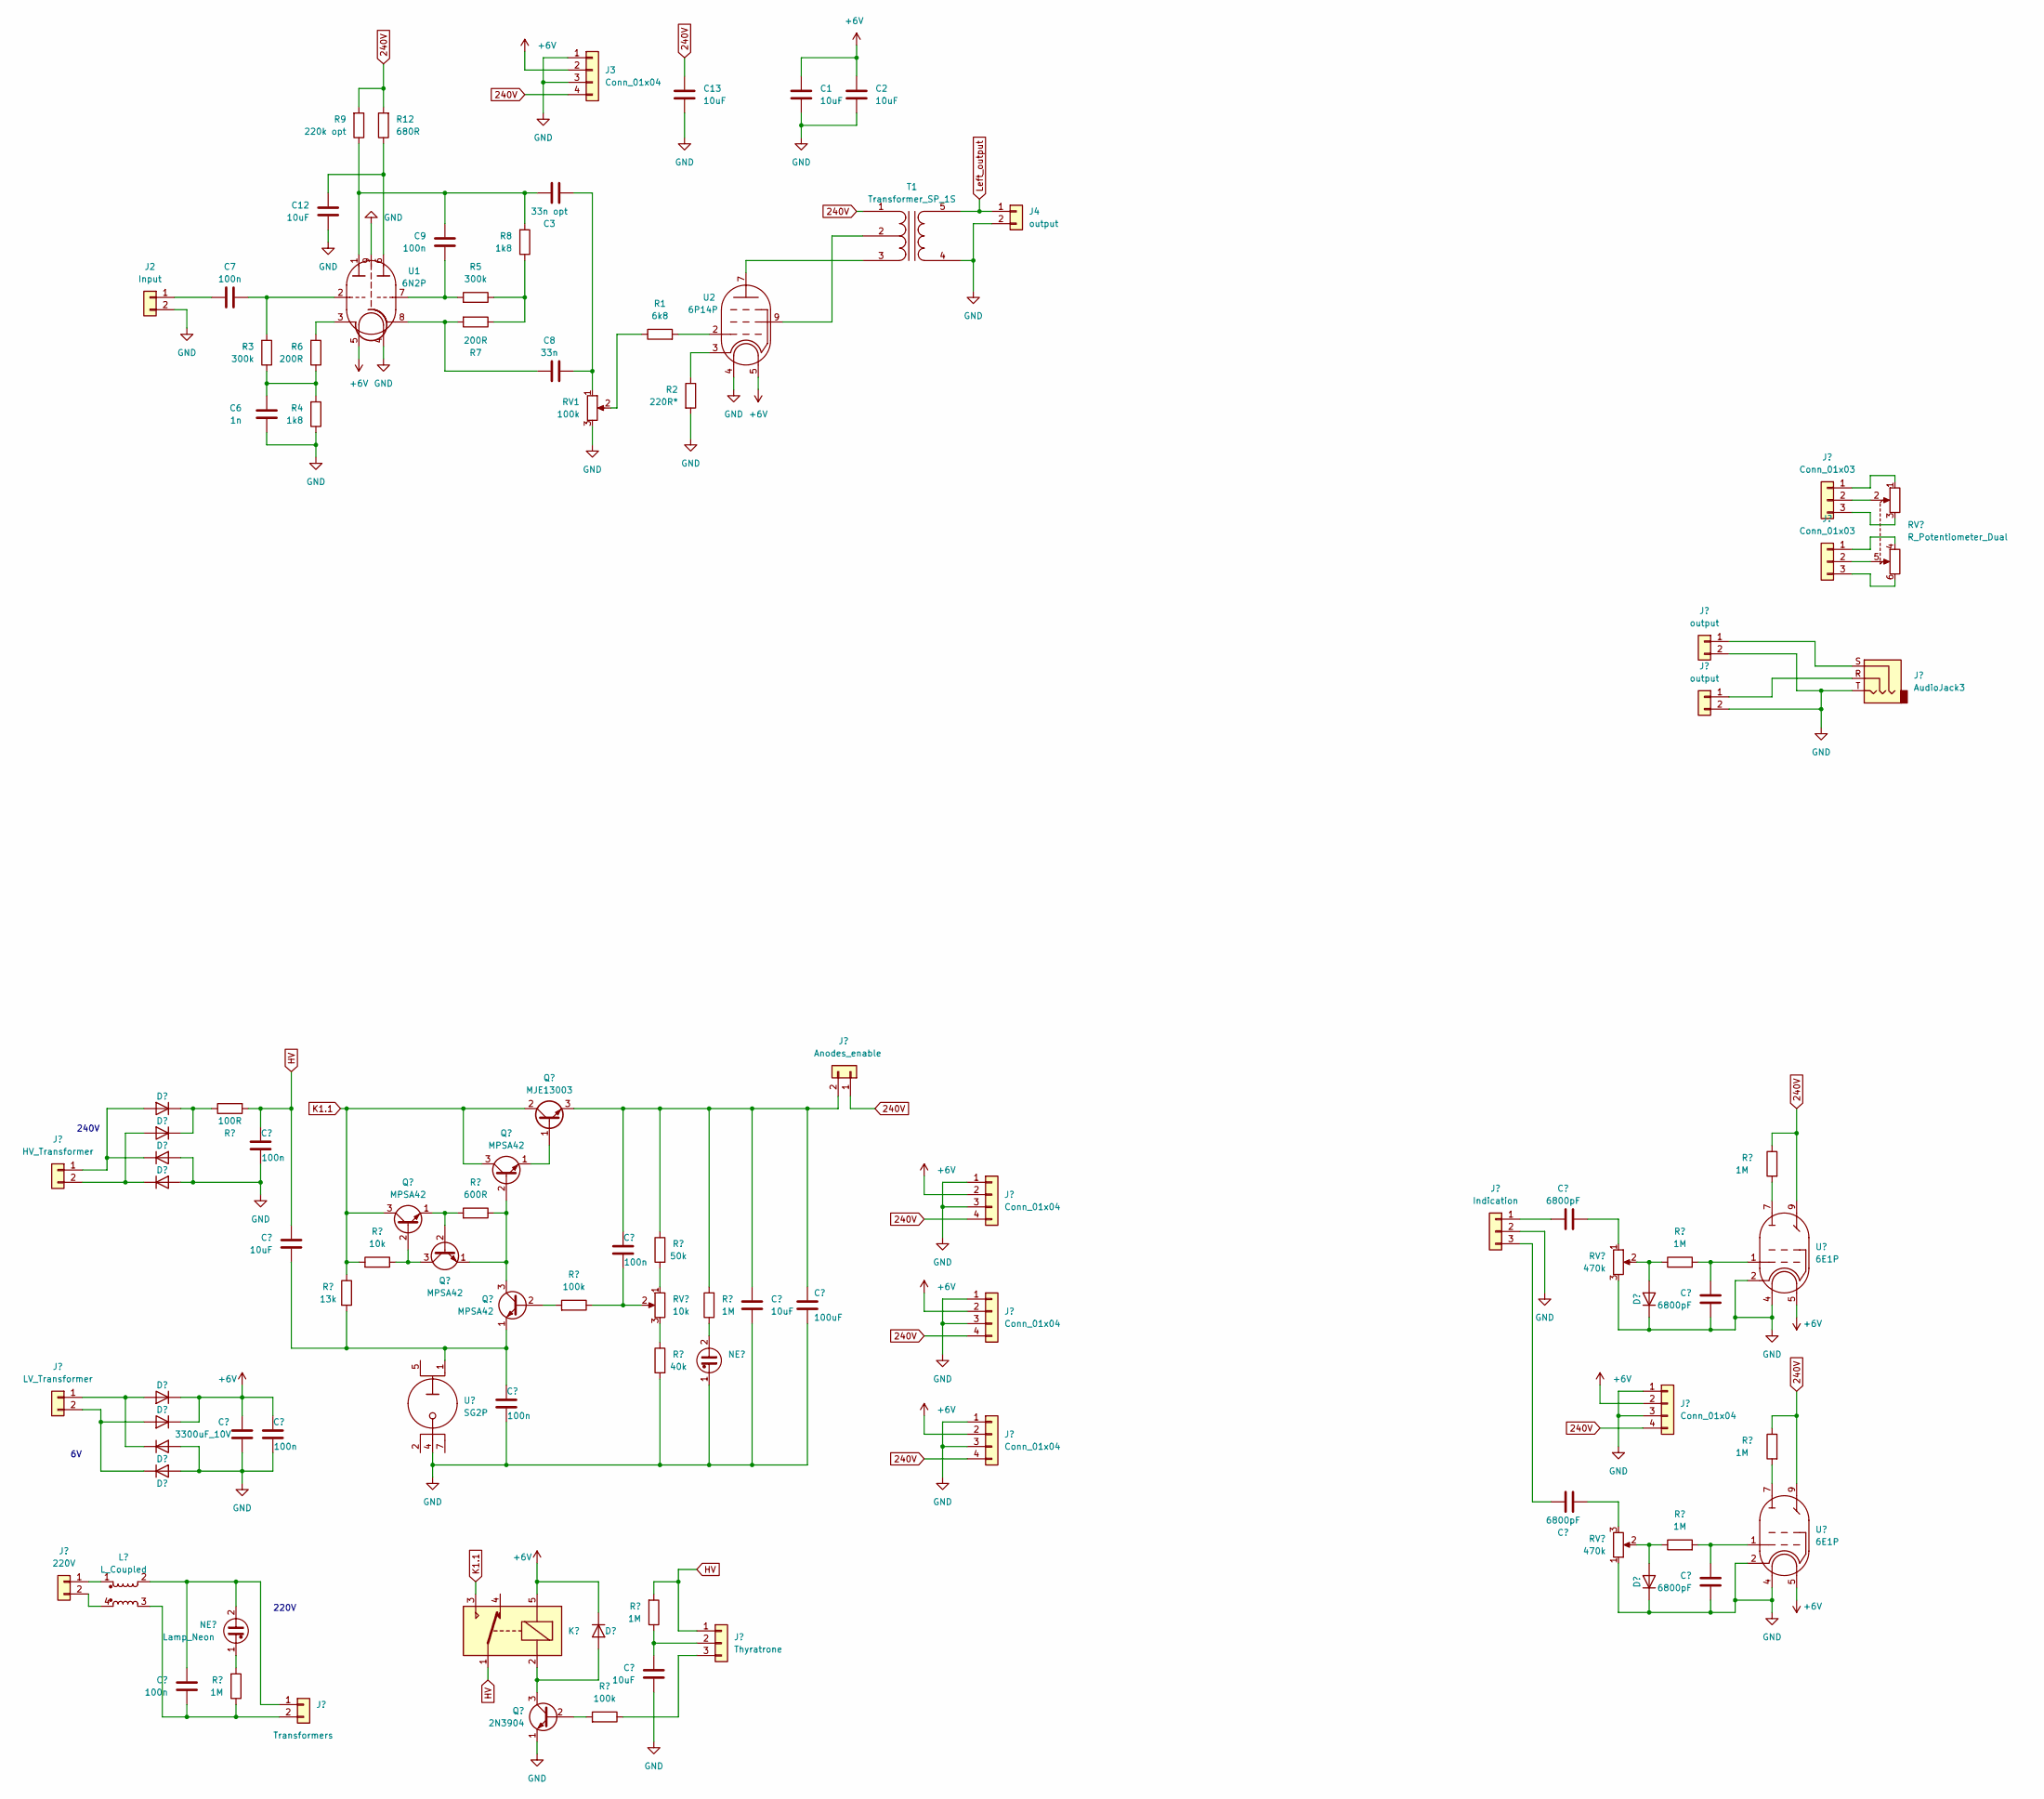
[picture p34: schematic Tube_amplifier.kicad_sch]

Parts:
C1, C2: 10uF; CP_Radial_D5.0mm_P2.00mm
C3: 33n opt; C_Rect_L7.2mm_W3.0mm_P5.00mm_FKS2_FKP2_MKS2_MKP2
C6: 1n; C_THT_K73-17_P5.00mm
C7, C9: 100n; C_THT_K73-17_P9.00mm
C8: 33n; C_Rect_L7.2mm_W3.0mm_P5.00mm_FKS2_FKP2_MKS2_MKP2
C12, C13: 10uF; C_THT_D10.0mm_P5.00mm
J2: Input; PinHeader_1x02_P2.54mm
J3: Conn_01x04; PinHeader_1x04_P2.54mm
J4: output; PinHeader_1x02_P2.54mm
R1: 6k8; R_THT_025W
R2: 220R*; R_THT_1W
R3, R5: 300k; R_THT_025W
R4, R8: 1k8; R_THT_025W
R6, R7: 200R; R_THT_025W
R9: 220k opt; R_THT_025W
R12: 680R; R_THT_025W
RV1: 100k; Potentiometer_THT_CA9V
T1: Transformer_SP_1S; Output_transformer
U1: 6N2P; 9-pin_tube_socket
U2: 6P14P; 9-pin_tube_socket

Connections:
240V: C13.1, J3.4, R9.2, R12.2, T1.1 (PR1)
+6V: C1.1, C2.1, J3.2, U1.5, U2.5
GND: C1.2, C2.2, C6.2, C12.2, C13.2, J2.2, J3.1, J3.3, J4.2, R2.2, R4.1, RV1.3, T1.4 (S1), U1.4, U1.9, U2.4
Left_output: J4.1, T1.5 (S2)
unnamed: C3.1, C9.2, R8.2, R9.1, U1.1
unnamed: C3.2, C8.2, RV1.1
unnamed: C6.1, R3.1, R4.2, R6.1
unnamed: C7.1, J2.1
unnamed: C7.2, R3.2, U1.2
unnamed: C8.1, R7.2, U1.8
unnamed: C9.1, R5.2, U1.7
unnamed: C12.1, R12.1, U1.6
unnamed: R1.1, RV1.2
unnamed: R1.2, U2.2
unnamed: R2.1, U2.3
unnamed: R5.1, R7.1, R8.1
unnamed: R6.2, U1.3
unnamed: T1.2 (PM), U2.9
unnamed: T1.3 (PR2), U2.7

Notes on the sheet:
240V
220V

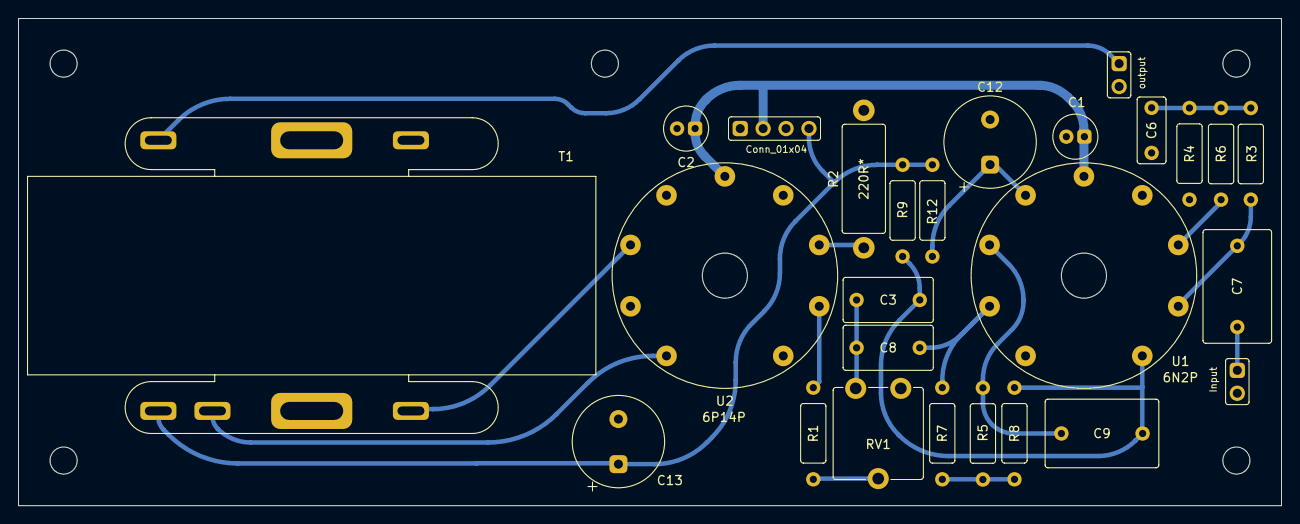
[picture p35: board Tube_amplifier.kicad_pcb from above]

Board: 2 copper layers, 140.0 x 54.0 mm, 26 parts (0 on the bottom side), 19 nets.
