servomouse/Tube_amplifier/Power_supply_filter.kicad_pcb

## KiCad design Power_supply_filter.kicad_pcb (2023-05-01)

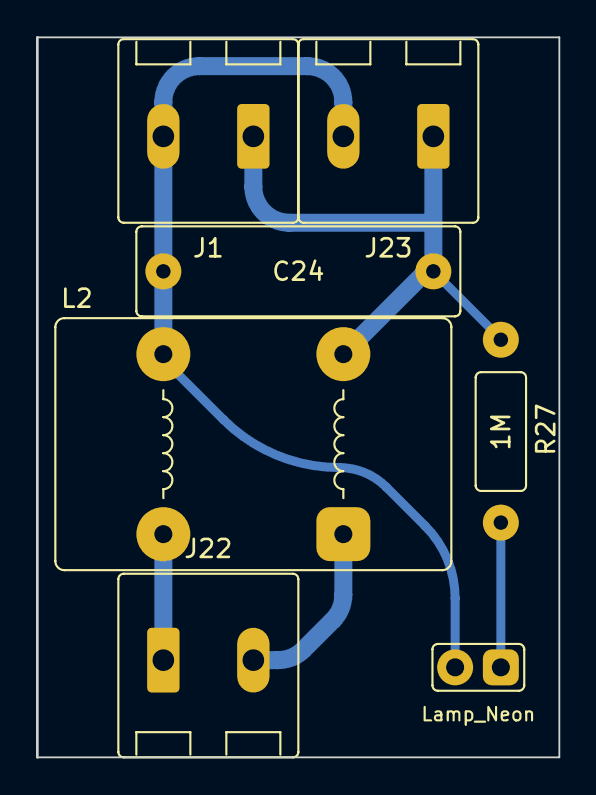
[picture p36: board Power_supply_filter.kicad_pcb from above]

Board: 2 copper layers, 29.0 x 40.0 mm, 7 parts (0 on the bottom side), 5 nets.

Parts:
C24: 100n; C_THT_K73-17_P15.00mm
J1, J23: Transformers; MCV_1,5_4-G-5.0_1x02_P5.0mm_Vertical
J22: 220V; MCV_1,5_4-G-5.0_1x02_P5.0mm_Vertical
L2: L_Coupled; L_THT_B82731-T
NE3: Lamp_Neon; PinHeader_1x02_P2.54mm
R27: 1M; R_THT_025W

Connections:
unnamed: C24.2, J1.1, J23.1, L2.2, R27.1
unnamed: C24.1, J1.2, J23.2, L2.3, NE3.2
unnamed: J22.1, L2.4
unnamed: J22.2, L2.1
unnamed: NE3.1, R27.2
