servomouse/Tube_amplifier/(commit log)

2022-12-11 Some tubes added
    [9-pin socket.FCStd, 9-pin socket.step, 9-pin socket.stl, Tube_amplifier.kicad_pcb, Tube_amplifier.kicad_sch]
2022-12-13 7-pin socket 3d model added
    [7-pin socket.FCStd, 7-pin socket.step, Tube_amplifier.kicad_pcb, Tube_amplifier.kicad_sch]
2022-12-13 Main part of schematic done
    [Tube_amplifier.kicad_sch]
2022-12-14 Output transformer added, pcb v0.1 ready
    [Output_transformer.FCStd, Output_transformer.step, Tube_amplifier.kicad_pcb, Tube_amplifier.kicad_sch]
2022-12-14 7-pin tube socket added
    [Tube_amplifier.kicad_pcb, Tube_amplifier.kicad_sch]
2022-12-16 Amplifier ready
    [Tube_amplifier.kicad_pcb, Tube_amplifier.kicad_sch]
2022-12-16 Power supply added
    [Asm.FCStd, Power_supply.kicad_pcb, Power_supply.step, Tube_amplifier.kicad_pcb, Tube_amplifier.kicad_sch, left_channel.kicad_pcb, right_channel.kicad_pcb]
2022-12-17 Indication board completed
    [Power_supply.kicad_pcb, Tube_amplifier.kicad_pcb, Tube_amplifier.kicad_sch]
2022-12-18 Some cleaning
    [Indication_board.kicad_pcb, Power_supply.kicad_pcb, Tube_amplifier.kicad_sch, left_channel.kicad_pcb]
2023-01-04 New schematic
    [Left_channel.kicad_pcb, Transformer_pins_holder.FCStd, Transformer_pins_holder.stl, Tube_amplifier.csv, Tube_amplifier.kicad_pcb, Tube_amplifier.kicad_sch, left_channel.kicad_pcb, output_stage_base.FCStd]
2023-01-04 Curved traces
    [Tube_amplifier.kicad_pcb, Tube_amplifier.kicad_sch]
2023-01-08 High Voltage stabilizer
    Create high voltage stabilizer
    [Indication_board.kicad_sch, Output&reg.kicad_sch, Power_supply.kicad_pcb, Power_supply.kicad_sch, Tube_amplifier.kicad_pcb, Tube_amplifier.kicad_sch]
2023-01-08 Multiple PCB
    [Amplifier.kicad_pcb, Amplifier.kicad_sch, Back_connectors.kicad_pcb, Back_connectors.kicad_sch, Front_connectors.kicad_pcb, Front_connectors.kicad_sch, Power_supply.kicad_pcb, Power_supply.kicad_sch]
2023-01-08 New power supply
    [Amplifier.kicad_sch, Back_connectors.kicad_sch, Front_connectors.kicad_sch, Indication_board.kicad_sch, Power_supply.kicad_pcb, Power_supply.kicad_sch, Tube_amplifier.kicad_sch]
2023-01-08 Curved traces on power supply PCB
    [Power_supply.kicad_pcb]
2023-01-11 New power supply schematic
    [Power_supply.kicad_pcb, Power_supply.kicad_sch, Tube_amplifier.kicad_sch]
2023-01-14 Wider pads
    [Amplifier.kicad_pcb, Power_supply.kicad_pcb]
2023-01-23 Wider pads
    First PCB version
    [Amplifier.kicad_pcb, Power_supply.kicad_pcb]
2023-01-23 Some 3d models
    [Bottom_chassis.step, Bottom_chassis.stl, Chassis.FCStd, bottom_chassis.FCStd]
2023-01-23 New power supply PCB
    [Power_supply.kicad_pcb, Power_supply.kicad_sch]
2023-01-24 Working on power supply PCB
    [Power_supply.kicad_pcb]
2023-01-25 New power supply PCB!
    [Power_supply.kicad_pcb]
2023-01-26 Power supply PCB final 1.0
    [Power_supply.kicad_pcb, Power_supply.kicad_sch]
2023-01-29 Some errors in the power supply PCB fixed
    [Power_supply.kicad_pcb, Power_supply.kicad_sch]
2023-01-30 Added heatsink on power mosfet
    [Power_supply.kicad_pcb]
2023-02-04 New amplifier PCB
    [Amplifier.kicad_pcb, Amplifier.kicad_sch, Power_supply.kicad_sch, vt_fb_rectifier.kicad_pcb, vt_fb_rectifier.kicad_sch]
2023-02-05 Back plate 3d model
    [Chassis.FCStd, back_plate.stl]
2023-02-06 Power transformer 3d model
    [Power_supply.kicad_pcb, Power_transformer.FCStd]
2023-02-14 Indication board PCB
    [Amplifier.kicad_pcb, Indication_board.kicad_pcb, Indication_board.kicad_sch, Indication_board.step]
2023-02-15 New 9-pin sockets
    [Amplifier.kicad_pcb, Indication_board.kicad_pcb, PL9-3P.FCStd, PL9-3P.step]
2023-02-18 Some improvements
    [Amplifier.kicad_pcb]
2023-02-21 Neon bulb added on the amplifier PCB
    [Amplifier.kicad_pcb, Amplifier.kicad_sch]
2023-03-04 Started redesigning power supply
    [Power_supply.kicad_pcb, Power_supply.kicad_sch]
2023-03-05 Continue rebuilding power supply PCB
    [Power_supply.kicad_pcb, Power_supply.kicad_sch]
2023-03-05 PCB almost done
    [Power_supply.kicad_pcb, Power_supply.kicad_sch]
2023-03-07 Rounded traces
    [Power_supply.kicad_pcb]
2023-03-08 New amplifier PCB with external transformer
    [Amplifier.kicad_pcb, Amplifier.kicad_sch]
2023-03-09 New Amplifier PCB almost ready
    [Amplifier.kicad_pcb]
2023-03-10 Power supply PCB updated
    [Amplifier.kicad_pcb, Power_supply.kicad_pcb]
2023-03-11 Rounded corners for power supply PCB
    [Power_supply.kicad_pcb, Power_supply.kicad_sch]
2023-03-13 More rounded corners!
    [Amplifier.kicad_pcb, Power_supply.kicad_pcb]
2023-05-01 Hybrid Amplifier
    [Amplifier.kicad_pcb, Amplifier.kicad_sch, Amplifier_hybrid.kicad_pcb, Amplifier_hybrid.kicad_sch, Angle_mounted_SG2P.kicad_pcb, Angle_mounted_SG2P.step, Chassis-Main_horizontal_plate.stl, Power_supply.kicad_pcb]
